Xhorn7/Skripsi-PENGEMBANGAN-ROBOT-AKUATIK-UNTUK-FEEDER-OTOMATIS-DI-TAMBAK/Master Code/Transmitter/README_RASPBERRY.md

# Panduan Menjalankan GUI Feeder di Raspberry Pi

Panel kontrol robot feeder akuatik. Jalankan **satu** berkas `receiverArduino.py`
→ GUI + telemetri + logging langsung aktif.

GUI berjalan **layar penuh mengikuti ukuran layar perangkat**, dirancang untuk
**layar sentuh 7 inci (800 × 480 px)** dengan tata letak bergaya mesin ATM:
tombol besar, tombol STOP yang selalu terlihat, dan papan angka layar penuh
sehingga bisa dioperasikan **tanpa keyboard maupun mouse**.

Layar pembuka hanya menawarkan **dua** pilihan — **MISI** dan **SETTING**.
Tidak ada bilah navigasi: **DASHBOARD terbuka sendiri** begitu misi dikirim.

---

## 1. Kebutuhan

### Perangkat keras
- Raspberry Pi (3/4/5) dengan **Raspberry Pi OS Desktop** (butuh layar/desktop untuk GUI —
  langsung ke monitor HDMI **atau** lewat VNC).
- **Layar sentuh 7 inci** (800 × 480) sebagai tampilan Pengendali Utama.
- Modul **NRF24L01** terhubung ke pin SPI Pi (lihat tabel wiring di bawah).
- Sudut MPU6050 **tidak perlu kabel USB lagi** — robot mengirimkannya sendiri
  lewat telemetri balik NRF.

### Perangkat lunak
- Python 3 (sudah bawaan Raspberry Pi OS).
- Paket sistem: `python3-tk` (untuk GUI), `python3-venv`.
- Paket Python: `customtkinter`, `pyrf24` (lihat `requirements.txt`).

---

## 2. Wiring NRF24L01 → Raspberry Pi

Kode memakai `RF24(24, 0)` → **CE = GPIO24**, **CSN = CE0 (SPI0)**.

| NRF24L01 | Raspberry Pi (BCM) | Pin fisik |
| --- | --- | --- |
| VCC | 3.3V | 1 atau 17 |
| GND | GND | 6, 9, ... |
| CE | GPIO24 | 18 |
| CSN | GPIO8 (CE0) | 24 |
| SCK | GPIO11 (SCLK) | 23 |
| MOSI | GPIO10 (MOSI) | 19 |
| MISO | GPIO9 (MISO) | 21 |

> **PENTING:** VCC NRF **wajib 3.3V** (bukan 5V). Disarankan tambah kapasitor
> 10µF antara VCC–GND modul NRF agar stabil.

---

## 3. Instalasi (sekali saja)

### Cara CEPAT (otomatis) — disarankan

Ekstrak zip ke `~/feeder`, lalu jalankan skrip setup sekali:

```bash
cd ~/feeder
chmod +x setup_pi.sh run.sh
./setup_pi.sh          # aktifkan SPI + apt + venv + pip install
# lalu LOGOUT-LOGIN sekali (agar grup spi/gpio/dialout aktif)
```

Setelah itu langsung ke **bagian 4 (Menjalankan)**.

### Cara MANUAL (kalau ingin bertahap)

Buka Terminal di Raspberry Pi:

```bash
# 3.1 Aktifkan SPI (untuk NRF24)
sudo raspi-config nonint do_spi 0        # 0 = enable
# (atau: sudo raspi-config -> Interface Options -> SPI -> Enable)

# 3.2 Paket sistem
sudo apt update
sudo apt install -y python3-venv python3-tk

# 3.3 Hak akses SPI / GPIO / Serial (lalu logout-login sekali)
sudo usermod -aG spi,gpio,dialout "$USER"

# 3.4 Salin folder ini ke Pi, mis. ke ~/feeder, lalu:
cd ~/feeder

# 3.5 Buat virtualenv (pakai --system-site-packages agar python3-tk terlihat)
python3 -m venv --system-site-packages ~/feeder-venv
source ~/feeder-venv/bin/activate

# 3.6 Install paket Python
pip install -r requirements.txt
```

---

## 4. Menjalankan

```bash
cd ~/feeder
./run.sh                 # buka GUI layar penuh (default)
# atau manual:
source ~/feeder-venv/bin/activate
python3 receiverArduino.py

./run.sh --windowed      # jendela 800x480 (untuk uji/pengembangan)
./run.sh --real          # langsung memakai NRF sungguhan
./run.sh --cli           # mode teks (tanpa GUI)
```

> **Mode awal = SIMULASI.** Aplikasi selalu terbuka dengan **robot virtual**
> supaya aman dipakai berlatih & demo tanpa menyalakan robot. Untuk mengendalikan
> robot sungguhan, sentuh tombol **MODE** di bilah atas (atau pilih **REAL** pada
> **SISTEM → MODE KERJA**, atau jalankan dengan `--real`). Perpindahan mode
> ditolak selagi ada perintah berjalan — tekan **STOP** dulu.

Kalau `run.sh` belum bisa dieksekusi: `chmod +x run.sh` sekali saja.
Saat layar penuh, tombol **Escape** atau **F11** mengembalikan ke mode jendela.

### Navigasi GUI

Alurnya lurus, bukan menu: **BERANDA → MISI → DASHBOARD**. Tombol **‹** di kiri
bilah atas mengembalikan ke beranda; tombol **STOP** merah di kanan aktif dari
halaman mana pun.

1. **BERANDA** — hanya dua tombol besar: **MISI** dan **SETTING**. Selagi ada
   misi berjalan, muncul tombol tambahan **LIHAT DASHBOARD** untuk kembali
   memantau.
2. **MISI** — sentuh kolom **Panjang** / **Lebar** (papan angka terbuka), atur
   lebar lintasan, kecepatan, dan titik awal (bisa juga disentuh langsung di
   peta). Panel kanan menampilkan preview jalur dan **daftar perintah** yang
   akan dikirim. Tekan **KIRIM MISI KE ROBOT** — aplikasi langsung berpindah ke
   DASHBOARD.
3. **DASHBOARD** — layar pemantauan selagi robot bekerja: status (`MENGIRIM
   PERINTAH → ROBOT BERGERAK → SELESAI` mengikuti sinyal `ON`/`FIN`), perintah
   yang sedang dijalankan, kemajuan antrean & sisa waktu, **koordinat sudut MPU
   (Roll/Pitch/Yaw)** yang dikirim robot, gauge baling-baling, serta tombol
   **HENTIKAN (STOP)** berukuran besar.
4. **SETTING** — tiga sub-halaman yang dipilih lewat pemilih di puncak layar:
   - **SISTEM** — saklar NRF / Heartbeat / Motor, pemilih **MODE KERJA**
     (SIMULASI/REAL), indikator monitor, info layar, tombol keluar.
   - **MANUAL** — kirim perintah sendiri: **MAJU dalam METER (0,1–50 m)**,
     **PUTAR KIRI (CCW, 1–180°)**, **PUTAR KANAN (CW, 1–180°)**. Pakai tombol
     −/+ atau **ISI ANGKA** (papan angka menerima pecahan, mis. `2.5`), lalu
     **KIRIM** — layar juga berpindah ke DASHBOARD. Jarak meter otomatis
     dipecah menjadi beberapa paket `FW` 10–200 cm sesuai protokol; jumlah
     paketnya diperlihatkan di bawah angka.
   - **LOG** — catatan realtime seluruh siklus protokol, saklar **Auto-simpan
     TXT** dan **Log MPU** (keduanya **sudah menyala sejak aplikasi dibuka**),
     serta **Export CSV / TXT** untuk simpan sekali jalan.

> **Sudut MPU tidak punya pengaturan port** — datanya ikut telemetri NRF dan
> mengalir sendiri di latar belakang selama heartbeat hidup.

### Berkas log & pembersihan otomatis

Sejak aplikasi dibuka, setiap kejadian (termasuk sudut MPU, satu baris per
detik) ditulis ke `logs/log_feeder_<tanggal>_<jam>.txt` **begitu terjadi**, jadi
catatan uji lapangan tetap utuh walau aplikasi ditutup paksa atau Pi kehilangan
daya. Berkas dalam folder itu yang **lebih tua dari 3 hari dihapus otomatis**
saat aplikasi dibuka dan tiap 6 jam sesudahnya, supaya kartu SD Raspberry Pi
tidak penuh. Berkas yang sedang ditulis tidak pernah ikut terhapus.

---

## 5. Masalah Umum

| Gejala | Penyebab / Solusi |
| --- | --- |
| GUI tak muncul, error `no display` | Jalankan dari sesi Desktop/VNC, bukan SSH polos. Untuk SSH pakai `export DISPLAY=:0` atau aktifkan VNC. |
| Ingin memakai NRF nyata | Mode awal memang SIMULASI. Sentuh tombol **MODE** di bilah atas, atau jalankan `./run.sh --real`. |
| Tombol MODE menolak pindah ke REAL | pyrf24 gagal / SPI belum aktif / wiring salah — pesannya muncul di dialog & log. Cek `ls /dev/spidev*` harus ada. |
| ROBOT = TERPUTUS terus | Robot belum menyala/listening, channel/address beda, atau NRF kurang daya (kapasitor 3.3V). |
| MPU kosong / "menunggu telemetri robot" | Robot belum mengirim telemetri. Pastikan **Heartbeat PING** menyala (SETTING > SISTEM), robot hidup, dan firmware mengirim `R=..;P=..;Y=..`. |
| Angka MPU **merah** + "MPU TIDAK TERBACA" | Robot melapor `S=0`: bus I2C-nya diam. Cek di sisi robot — SDA=GPIO21, SCL=GPIO22, VCC=3.3V, GND tersambung, AD0→GND, kabel I2C jangan panjang & jauhkan dari kabel daya ESC. |
| MPU diam di `Roll=-90.0 Pitch=90.0 Yaw=-0.0` | **Sama dengan di atas** — angka itu sidik jari I2C yang tidak menjawab (`atan2(-6.1e-5, 0) = -90°` PAS), bukan sudut sungguhan. Bukan masalah kalibrasi. |
| Yaw merayap pelan (mis. +0,1°/detik) padahal robot **diam** | Sensor terbaca, tapi **offset gyro belum dihitung** (`calcGyroOffsets` tak pernah jalan → offset = 0). Firmware sekarang menyusulkannya otomatis saat menganggur; Serial akan mencetak `Kalibrasi gyro selesai`. Pastikan robot benar-benar diam & datar saat itu. |
| Perlu tahu penyebab pasti MPU bermasalah | Flash sketch diagnosa: `pio run -e mpudiag -t upload && pio device monitor`. Ia memindai seluruh bus I2C, membaca `WHO_AM_I` & bit SLEEP, mendump 14 byte register mentah, lalu mencetak **vonis** beserta langkah pemeriksaannya. |
| Log lama hilang sendiri | Memang disengaja: berkas > 3 hari dibuang otomatis. Salin dulu lewat **Export CSV/TXT** bila ingin disimpan lama. |
| Auto-simpan berhenti sendiri | Berkas gagal ditulis (kartu SD penuh / read-only). Sebabnya tampil di samping saklar; perbaiki lalu nyalakan lagi. |
| `ModuleNotFoundError: customtkinter` | venv belum diaktifkan / `pip install -r requirements.txt` belum jalan. |

---

## 6. (Opsional) Auto-start saat boot

Buat file `~/.config/autostart/feeder.desktop`:

```ini
[Desktop Entry]
Type=Application
Name=Feeder GUI
Exec=/home/pi/feeder/run.sh
```

Ganti `/home/pi/feeder/` sesuai lokasi foldermu.

---

## 7. Isi Paket

| Berkas | Fungsi |
| --- | --- |
| `receiverArduino.py` | **Entry point** — jalankan ini |
| `feeder_gui.py` | Antarmuka GUI (CustomTkinter) |
| `feeder_core.py` | Backend: perintah FW/CW/CCW/STOP, radio (REAL/SIMULASI), runner, logger + auto-simpan, MPUMonitor |
| `requirements.txt` | Daftar dependensi Python |
| `setup_pi.sh` | Skrip instalasi otomatis (jalankan sekali) |
| `run.sh` | Launcher (aktifkan venv + jalankan) |
| `Dokumentasi_GUI_Feeder_SDLC.pdf` | Dokumentasi lengkap (metode SDLC) |
| `logs/` | Berkas auto-simpan TXT (dibuat otomatis; isi > 3 hari dihapus sendiri) |
