Xhorn7/Skripsi-PENGEMBANGAN-ROBOT-AKUATIK-UNTUK-FEEDER-OTOMATIS-DI-TAMBAK/Master Code/Robot/New/Finalnew/Pin Details.txt

NRF24:
| NRF24 | ESP32  |
| ----- | --- |
| CE | GPIO4 |
| CSN | GPIO5 |
| MOSI  | GPIO23 |
| MISO  | GPIO19 |
| SCK | GPIO18 |
| VCC | 3.3V |
| GND | GND |

MPU6050:
| MPU6050 | ESP32  |
| --- | --- |
| SDA | GPIO21 |
| SCL | GPIO22 |
| VCC | 3.3V |
| GND | GND |

ESC (motor):
| ESC | ESP32 |
| --- | --- |
| Signal Left  | GPIO25 |
| Signal Right | GPIO26 |
| GND ESC | GND ESP32 |
