Xhorn7/Skripsi-PENGEMBANGAN-ROBOT-AKUATIK-UNTUK-FEEDER-OTOMATIS-DI-TAMBAK/Flowchart Images/02-2-flowchart-pengendali-utama-transmitter.png

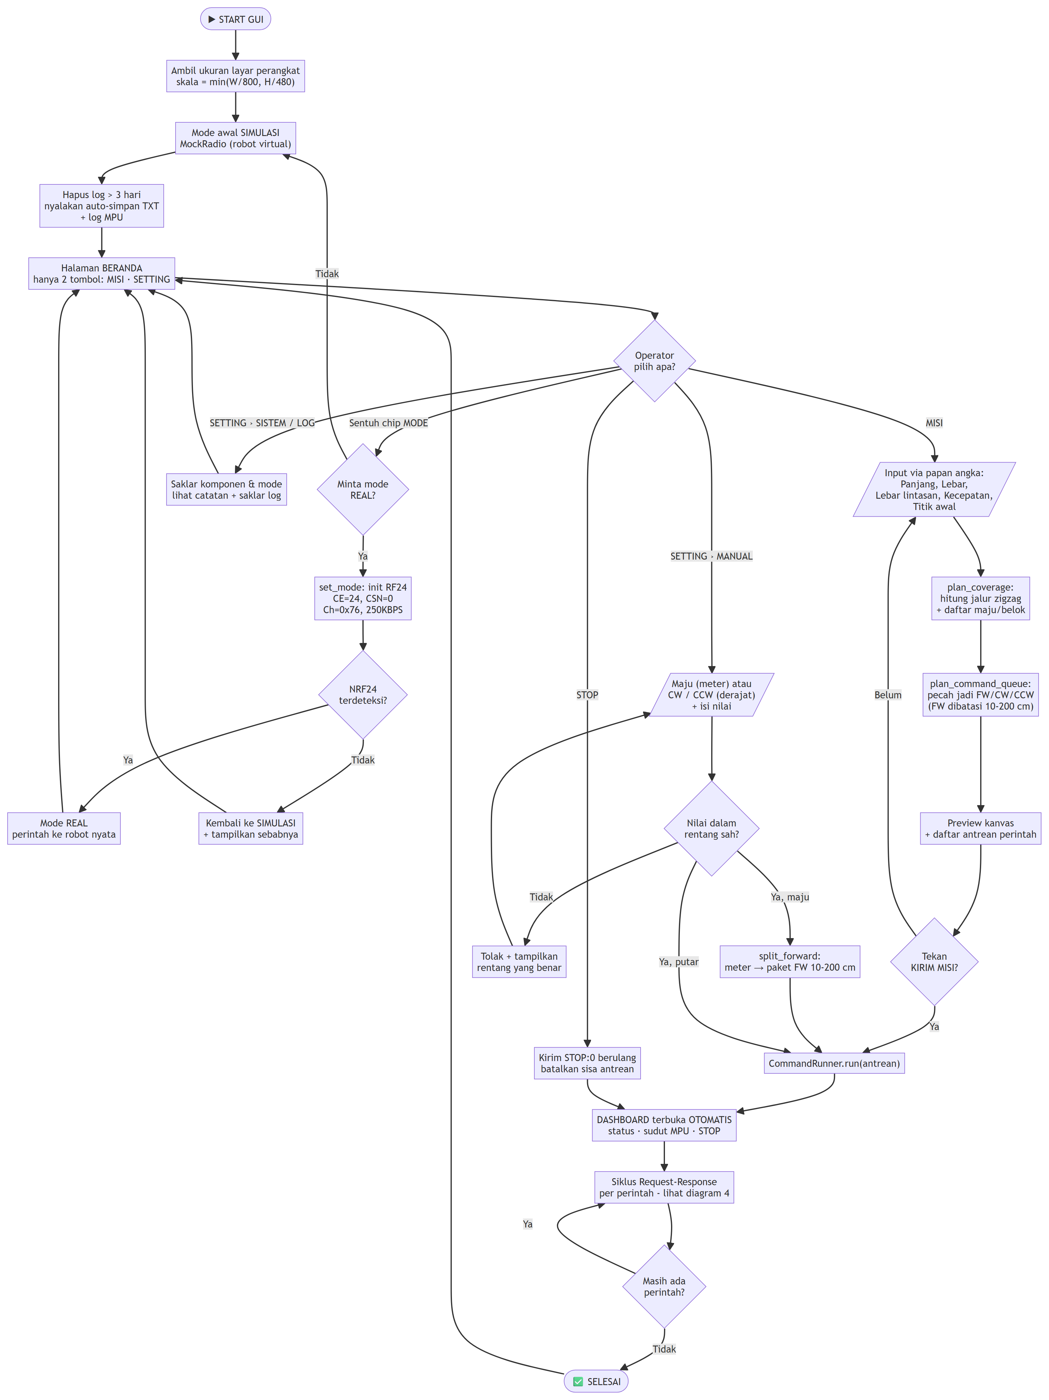
Flowchart Images/02-2-flowchart-pengendali-utama-transmitter.png
