Xhorn7/Skripsi-PENGEMBANGAN-ROBOT-AKUATIK-UNTUK-FEEDER-OTOMATIS-DI-TAMBAK/Flowchart Images/03-3-flowchart-body-robot-receiver.png

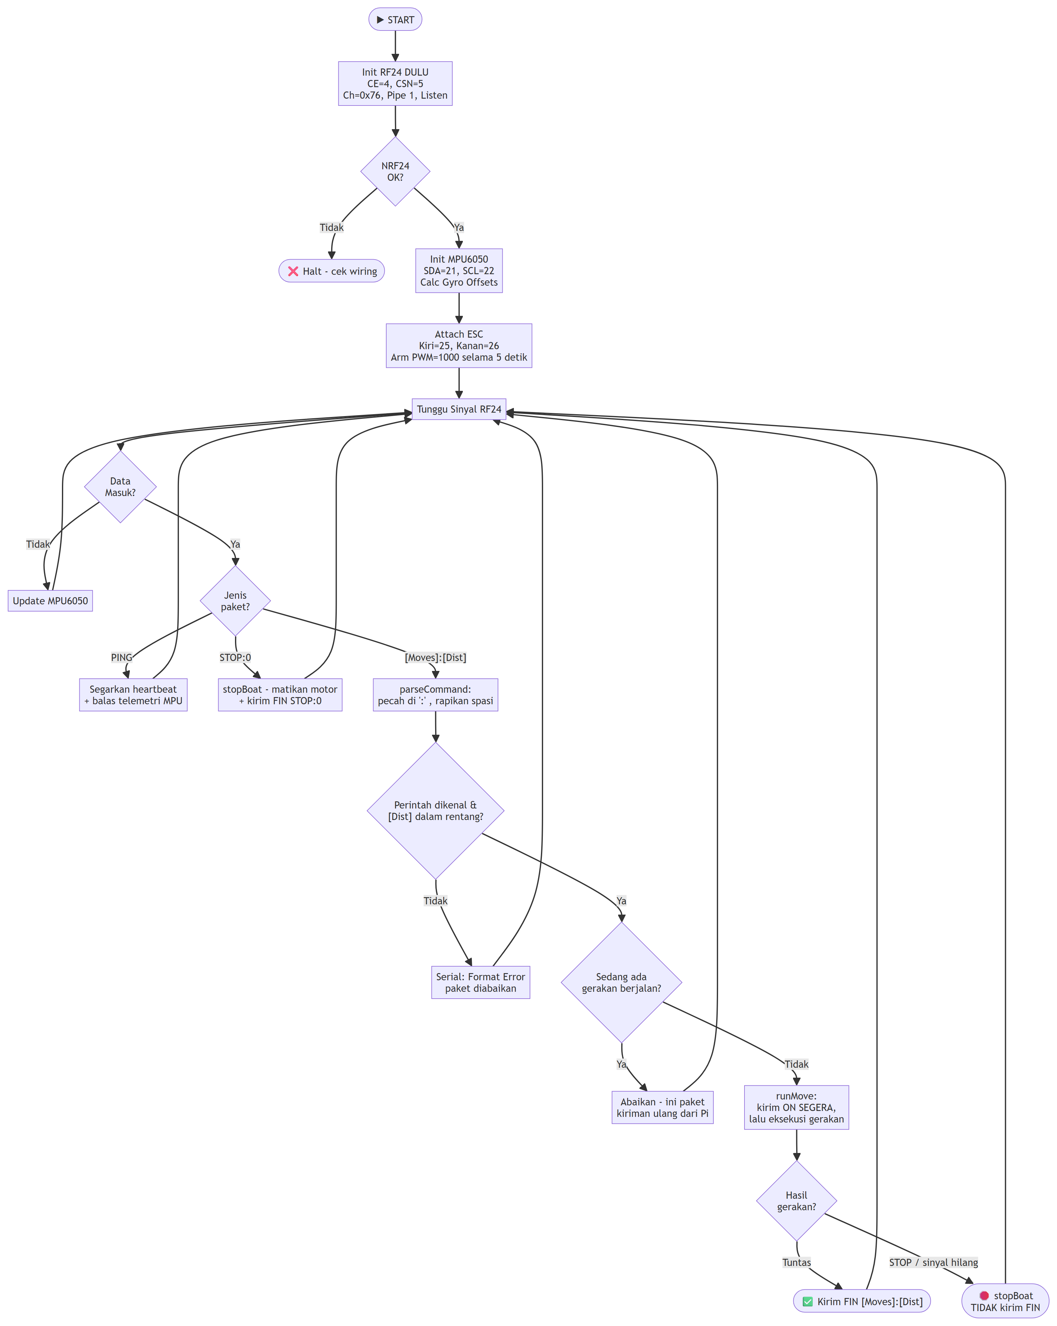
Flowchart Images/03-3-flowchart-body-robot-receiver.png
