Xhorn7/Skripsi-PENGEMBANGAN-ROBOT-AKUATIK-UNTUK-FEEDER-OTOMATIS-DI-TAMBAK/Flowchart Images/04-4-siklus-request-response-satu-perintah.png

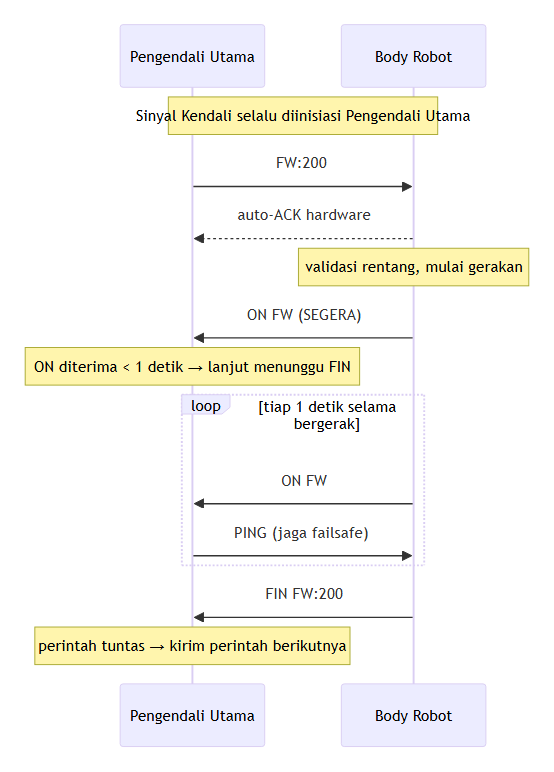
Flowchart Images/04-4-siklus-request-response-satu-perintah.png
