Xhorn7/Skripsi-PENGEMBANGAN-ROBOT-AKUATIK-UNTUK-FEEDER-OTOMATIS-DI-TAMBAK/Flowchart Images/05-4-siklus-request-response-satu-perintah-2.png

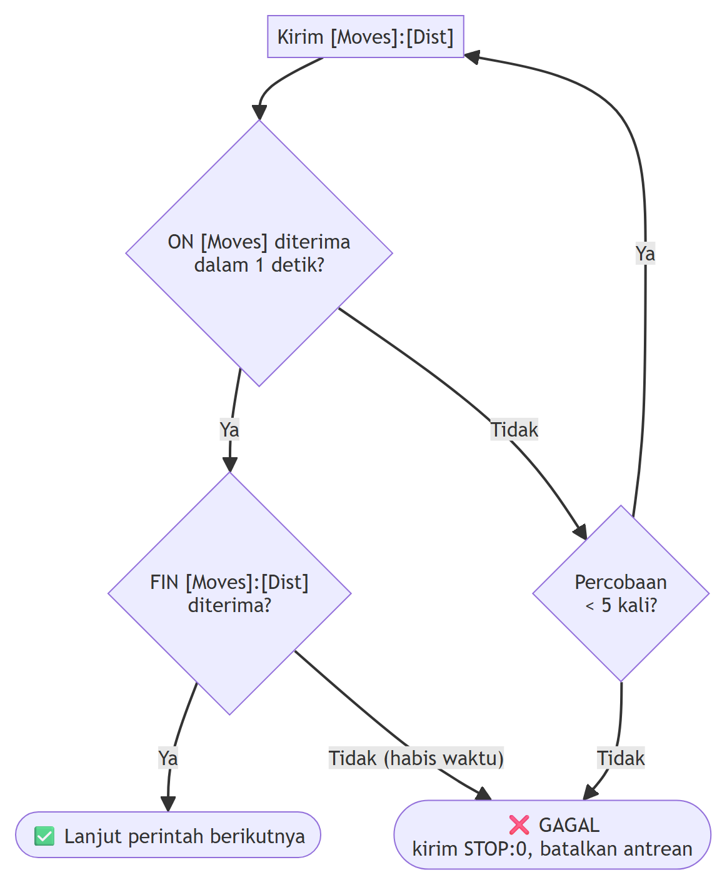
Flowchart Images/05-4-siklus-request-response-satu-perintah-2.png
