Xhorn7/Skripsi-PENGEMBANGAN-ROBOT-AKUATIK-UNTUK-FEEDER-OTOMATIS-DI-TAMBAK/Flowchart Images/06-5-perintah-fw-heading-hold-proporsional-executeforward.png

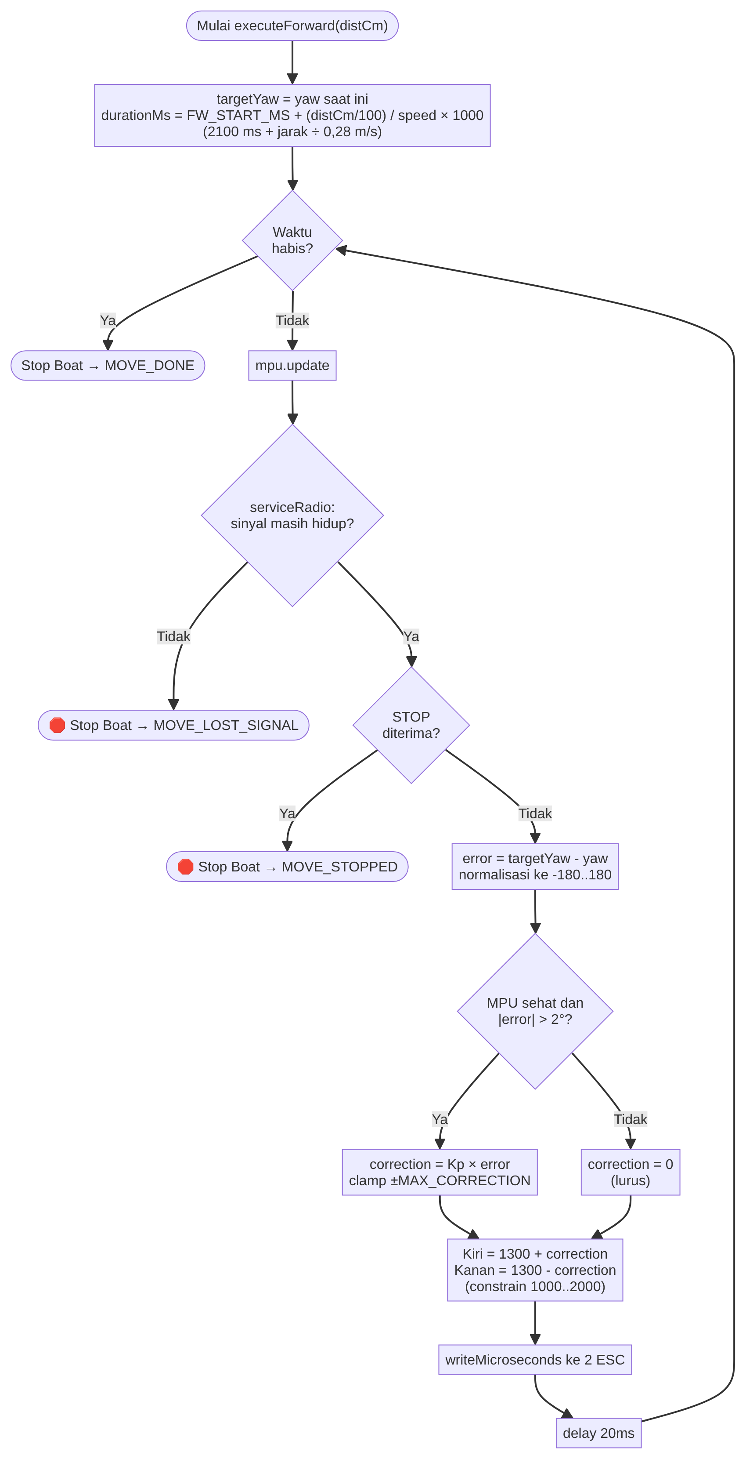
Flowchart Images/06-5-perintah-fw-heading-hold-proporsional-executeforward.png
