Xhorn7/Skripsi-PENGEMBANGAN-ROBOT-AKUATIK-UNTUK-FEEDER-OTOMATIS-DI-TAMBAK/Flowchart Images/07-6-perintah-cw-ccw-putaran-closed-loop-yaw-executeturn.png

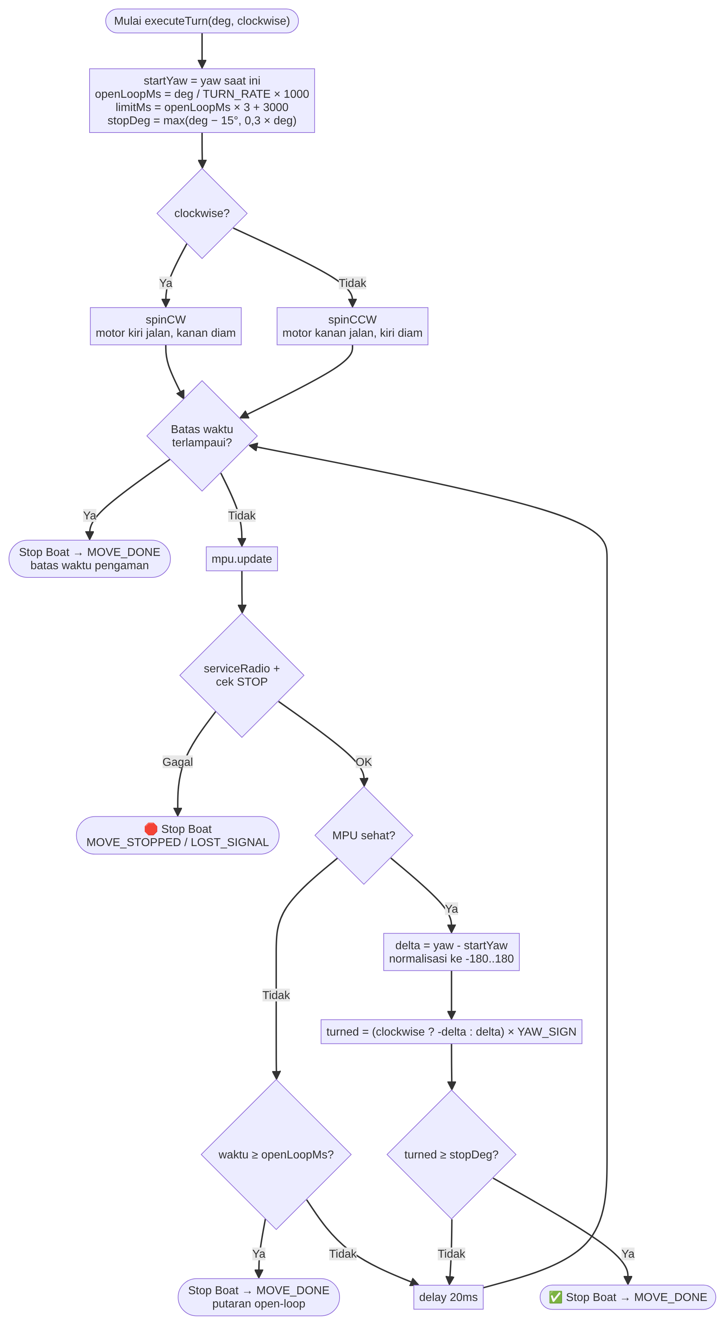
Flowchart Images/07-6-perintah-cw-ccw-putaran-closed-loop-yaw-executeturn.png
