Xhorn7/Skripsi-PENGEMBANGAN-ROBOT-AKUATIK-UNTUK-FEEDER-OTOMATIS-DI-TAMBAK/Flowchart Images/08-7-perencanaan-jalur-antrean-perintah.png

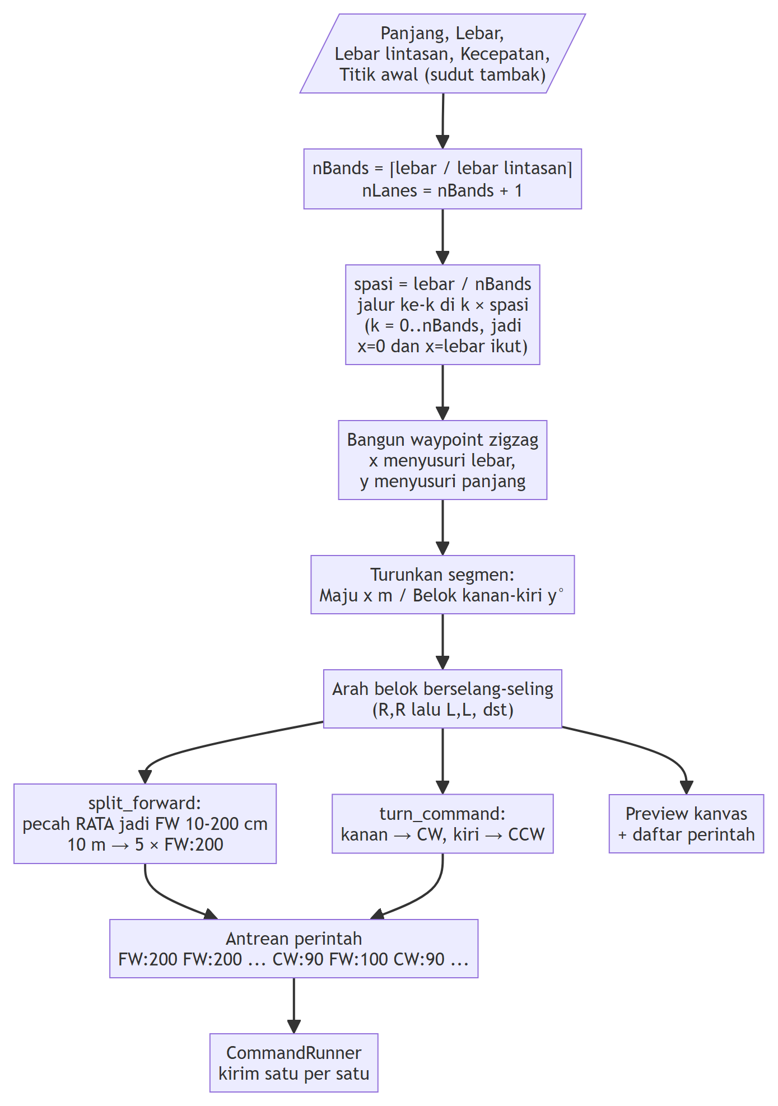
Flowchart Images/08-7-perencanaan-jalur-antrean-perintah.png
