Xhorn7/Skripsi-PENGEMBANGAN-ROBOT-AKUATIK-UNTUK-FEEDER-OTOMATIS-DI-TAMBAK/Flowchart Images/09-8-sinyal-balik-telemetri-half-duplex-gantian.png

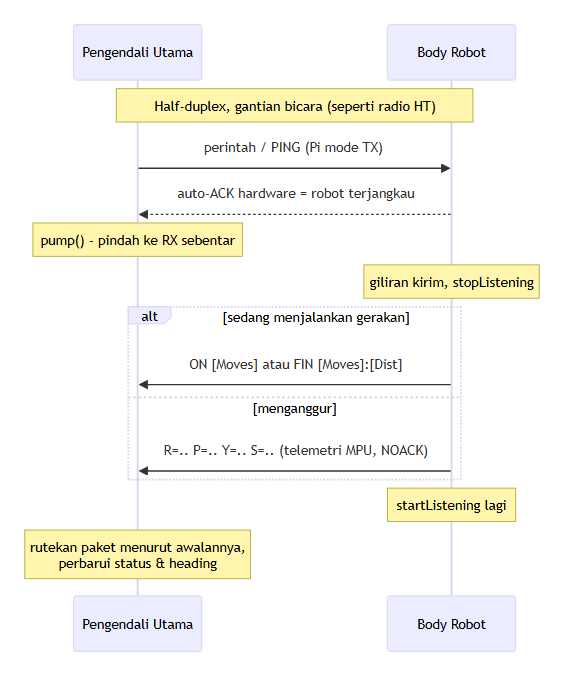
Flowchart Images/09-8-sinyal-balik-telemetri-half-duplex-gantian.png
