Xhorn7/Skripsi-PENGEMBANGAN-ROBOT-AKUATIK-UNTUK-FEEDER-OTOMATIS-DI-TAMBAK/Master Code/Transmitter/gui_beranda.png

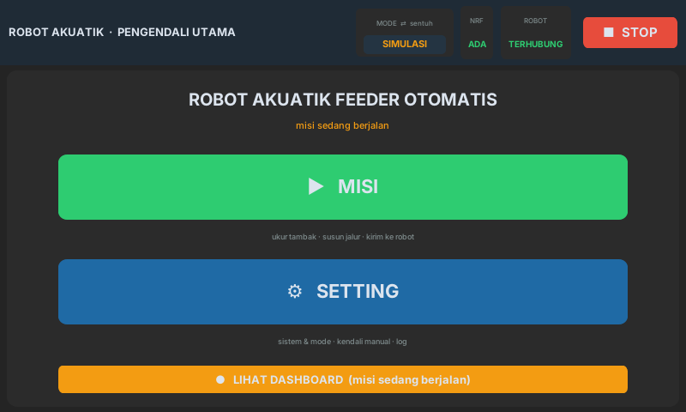
Master Code/Transmitter/gui_beranda.png
