Xhorn7/Skripsi-PENGEMBANGAN-ROBOT-AKUATIK-UNTUK-FEEDER-OTOMATIS-DI-TAMBAK/Pengujian/foto_c1/C1-1_akhir.webp

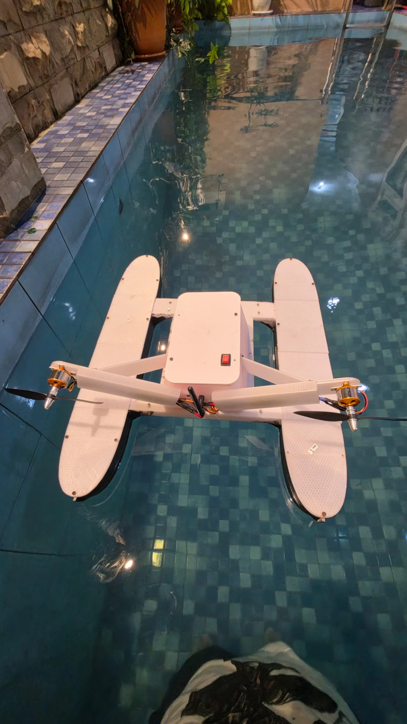
Pengujian/foto_c1/C1-1_akhir.webp
