Xhorn7/Skripsi-PENGEMBANGAN-ROBOT-AKUATIK-UNTUK-FEEDER-OTOMATIS-DI-TAMBAK/Pengujian/foto_c1/C1-2_akhir_C1-3_awal.webp

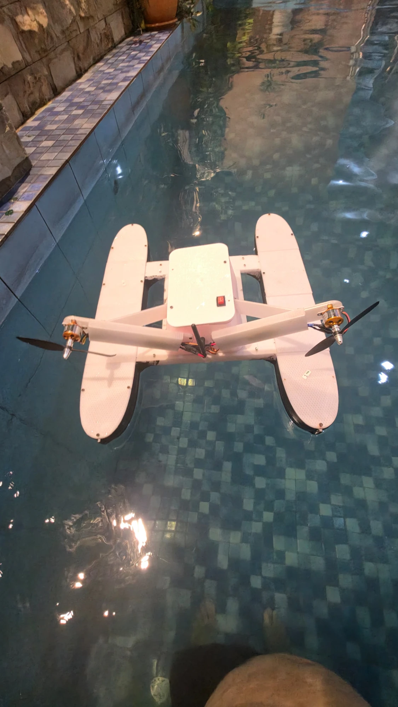
Pengujian/foto_c1/C1-2_akhir_C1-3_awal.webp
