Xhorn7/Skripsi-PENGEMBANGAN-ROBOT-AKUATIK-UNTUK-FEEDER-OTOMATIS-DI-TAMBAK/Pengujian/gambar/fig_c1_rute_aktual.png

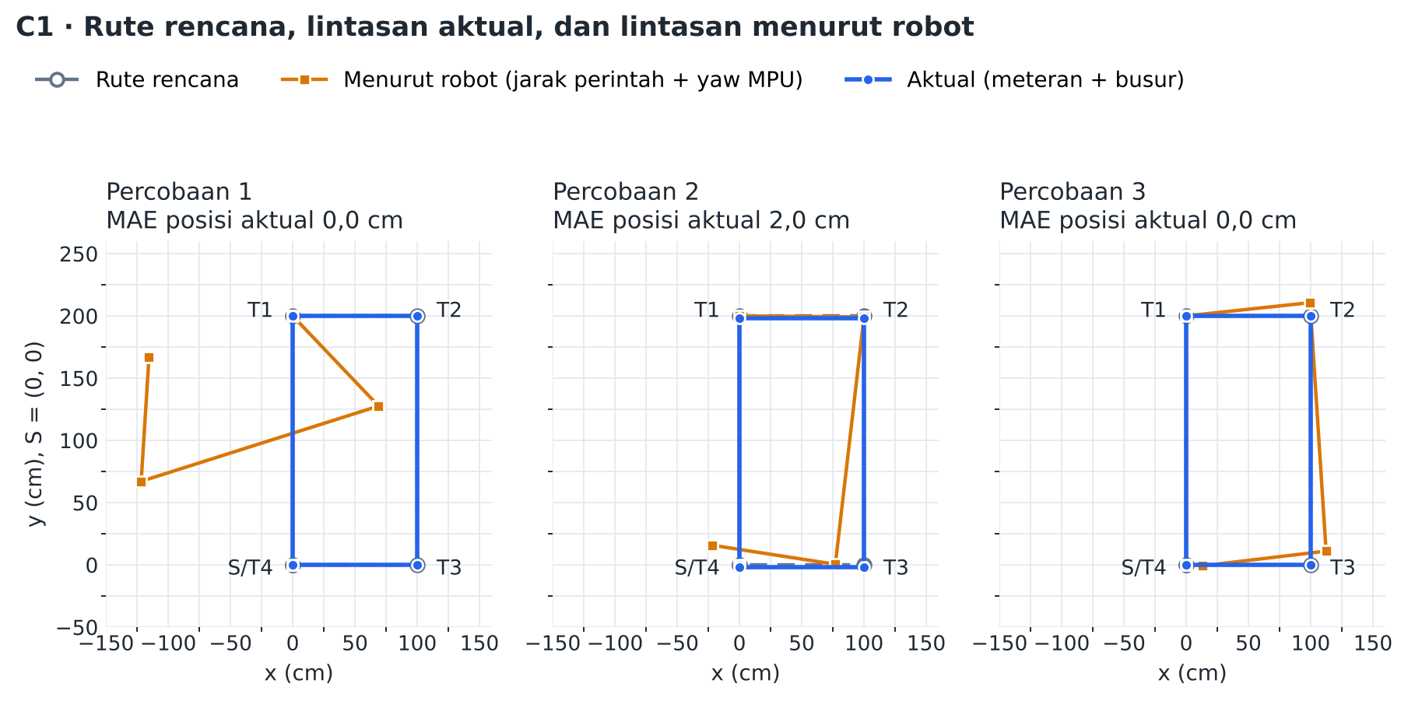
Pengujian/gambar/fig_c1_rute_aktual.png
