Xhorn7/Skripsi-PENGEMBANGAN-ROBOT-AKUATIK-UNTUK-FEEDER-OTOMATIS-DI-TAMBAK/Pengujian/gambar/fig_kolam_skenario.png

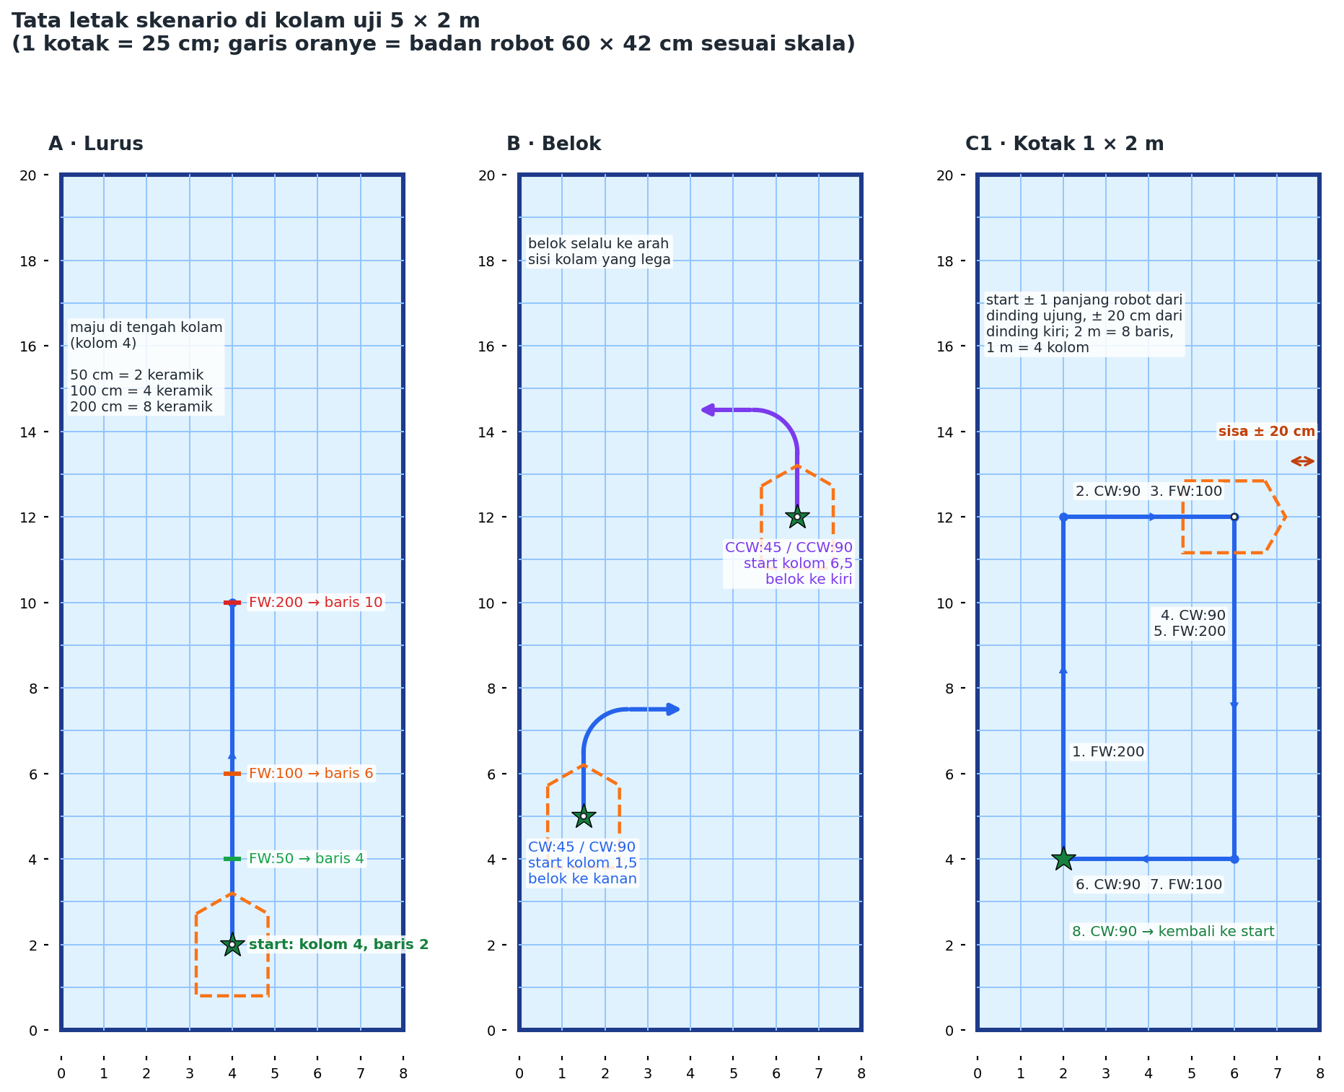
Pengujian/gambar/fig_kolam_skenario.png
