Xhorn7/Skripsi-PENGEMBANGAN-ROBOT-AKUATIK-UNTUK-FEEDER-OTOMATIS-DI-TAMBAK/Pengujian/Lembar_Data_Pengujian_Sebelum Kalibrasi.xlsx

Sheet: Data Sesi
Data Sesi Pengujian
Tanggal / jam mulai | 29 September 2026 12:00 WIB
Ukuran 1 keramik (cm) | 25 cm
Ukuran 1 mozaik (cm) | 4.1 cm
Pojok acuan (0 ; 0) | 1:4
Baterai penuh saat mulai (Y/T) | Y
Status MPU (S)
ROBOT_SPEED_MPS
KP_HEADING
Ukuran melintang C1/C2 (hasil uji coba ruang)
Cuaca / angin / riak air | Hujan
Pencatat
Cara pakai
1. Tiap skenario punya satu sheet. Isi hanya sel kuning.
2. Skenario A: isi baris saat FIN (kalau sempat), lalu kolom & baris posisi akhir.
3. Skenario B & C: isi posisi haluan dan buritan setelah robot diam.
4. Jarak, galat, sudut, rata-rata, MAE, MAPE, dan simpangan baku terhitung sendiri.

Sheet: A1
A1 — FW:50 (target 50 cm, start kolom 4 ; baris 2)
Perc. | Baris saat FIN (opsional) | Kolom akhir | Baris akhir | Jarak aktual (cm) | Galat (cm) | Galat (%) | Lateral (cm) | Jarak luncur (cm) | Kirim ulang? (Y/T) | Keterangan
1 |  | 4 | 2 | 0 | -50 | -100 | 0 |  | T
2 |  | 4 | 2 | 0 | -50 | -100 | 0 |  | T
3 |  | 4 | 2 | 0 | -50 | -100 | 0 |  | T
Rata-rata |  | 4 | 2 | 0 | -50 | -100 | 0 |  | T
Simpangan baku |  | 0 | 0 | 0 | 0 | 0 | 0 |  | T
MAE (cm) | 50
MAPE (%) | 100
Kuning = diisi manual (hasil baca grid keramik). Abu-abu = otomatis, jangan diketik.

Sheet: A2
A2 — FW:100 (target 100 cm, start kolom 4 ; baris 2)
Perc. | Baris saat FIN (opsional) | Kolom akhir | Baris akhir | Jarak aktual (cm) | Galat (cm) | Galat (%) | Lateral (cm) | Jarak luncur (cm) | Kirim ulang? (Y/T) | Keterangan
1 |  | 4.5 | 2 | 0 | -100 | -100 | 12.5
2 |  | 4.5 | 2 | 0 | -100 | -100 | 12.5
3 |  | 4.5 | 2 | 0 | -100 | -100 | 12.5
Rata-rata |  | 4.5 | 2 | 0 | -100 | -100 | 12.5
Simpangan baku |  | 0 | 0 | 0 | 0 | 0 | 0
MAE (cm) | 100
MAPE (%) | 100
Kuning = diisi manual (hasil baca grid keramik). Abu-abu = otomatis, jangan diketik.

Sheet: A3
A3 — FW:200 (target 200 cm, start kolom 4 ; baris 2)
Perc. | Baris saat FIN (opsional) | Kolom akhir | Baris akhir | Jarak aktual (cm) | Galat (cm) | Galat (%) | Lateral (cm) | Jarak luncur (cm) | Kirim ulang? (Y/T) | Keterangan
1 |  | 4 | 5 | 75 | -125 | -62.5 | 0
2 |  | 4 | 5 | 75 | -125 | -62.5 | 0
3 |  | 4 | 5 | 75 | -125 | -62.5 | 0
Rata-rata |  | 4 | 5 | 75 | -125 | -62.5 | 0
Simpangan baku |  | 0 | 0 | 0 | 0 | 0 | 0
MAE (cm) | 125
MAPE (%) | 62.5
Kuning = diisi manual (hasil baca grid keramik). Abu-abu = otomatis, jangan diketik.

Sheet: B1
B1 — CW:45 (target 45°, arah awal 0° sejajar garis baris)
Perc. | Yaw MPU awal (°) | Yaw MPU akhir (°) | Haluan kolom | Haluan baris | Buritan kolom | Buritan baris | Sudut MPU (°) | Sudut aktual (°) | Galat aktual (°) | Galat MPU vs aktual (°) | Keterangan
1
2
3
Rata-rata
Simpangan baku
MAE sudut (°)
MAE MPU (°)
Kuning = diisi manual (hasil baca grid keramik). Abu-abu = otomatis, jangan diketik.

Sheet: B2
B2 — CW:90 (target 90°, arah awal 0° sejajar garis baris)
Perc. | Yaw MPU awal (°) | Yaw MPU akhir (°) | Haluan kolom | Haluan baris | Buritan kolom | Buritan baris | Sudut MPU (°) | Sudut aktual (°) | Galat aktual (°) | Galat MPU vs aktual (°) | Keterangan
1
2
3
Rata-rata
Simpangan baku
MAE sudut (°)
MAE MPU (°)
Kuning = diisi manual (hasil baca grid keramik). Abu-abu = otomatis, jangan diketik.

Sheet: B3
B3 — CCW:45 (target 45°, arah awal 0° sejajar garis baris)
Perc. | Yaw MPU awal (°) | Yaw MPU akhir (°) | Haluan kolom | Haluan baris | Buritan kolom | Buritan baris | Sudut MPU (°) | Sudut aktual (°) | Galat aktual (°) | Galat MPU vs aktual (°) | Keterangan
1
2
3
Rata-rata
Simpangan baku
MAE sudut (°)
MAE MPU (°)
Kuning = diisi manual (hasil baca grid keramik). Abu-abu = otomatis, jangan diketik.

Sheet: B4
B4 — CCW:90 (target 90°, arah awal 0° sejajar garis baris)
Perc. | Yaw MPU awal (°) | Yaw MPU akhir (°) | Haluan kolom | Haluan baris | Buritan kolom | Buritan baris | Sudut MPU (°) | Sudut aktual (°) | Galat aktual (°) | Galat MPU vs aktual (°) | Keterangan
1
2
3
Rata-rata
Simpangan baku
MAE sudut (°)
MAE MPU (°)
Kuning = diisi manual (hasil baca grid keramik). Abu-abu = otomatis, jangan diketik.

Sheet: C1
C1 — Kotak 1 x 2 m (target kolom 2 ; baris 4)
Perc. | Kolom akhir | Baris akhir | Haluan kolom | Haluan baris | Buritan kolom | Buritan baris | Δ kolom | Δ baris | Galat posisi (cm) | Arah akhir (°) | FIN (…/8) | Waktu total (s) | Keterangan
1
2
3
Rata-rata
Simpangan baku
MAE posisi (cm)
Kuning = diisi manual (hasil baca grid keramik). Abu-abu = otomatis, jangan diketik.

Sheet: C2
C2 — Zigzag mini (target kolom 2 ; baris 4)
Perc. | Kolom akhir | Baris akhir | Haluan kolom | Haluan baris | Buritan kolom | Buritan baris | Δ kolom | Δ baris | Galat posisi (cm) | Arah akhir (°) | FIN (…/13) | Waktu total (s) | Keterangan
1
2
3
Rata-rata
Simpangan baku
MAE posisi (cm)
Kuning = diisi manual (hasil baca grid keramik). Abu-abu = otomatis, jangan diketik.
