Xhorn7/Skripsi-PENGEMBANGAN-ROBOT-AKUATIK-UNTUK-FEEDER-OTOMATIS-DI-TAMBAK/Schematic/Schematic New.pdf

### ESP32-WROOM-32

### NRF24L01+

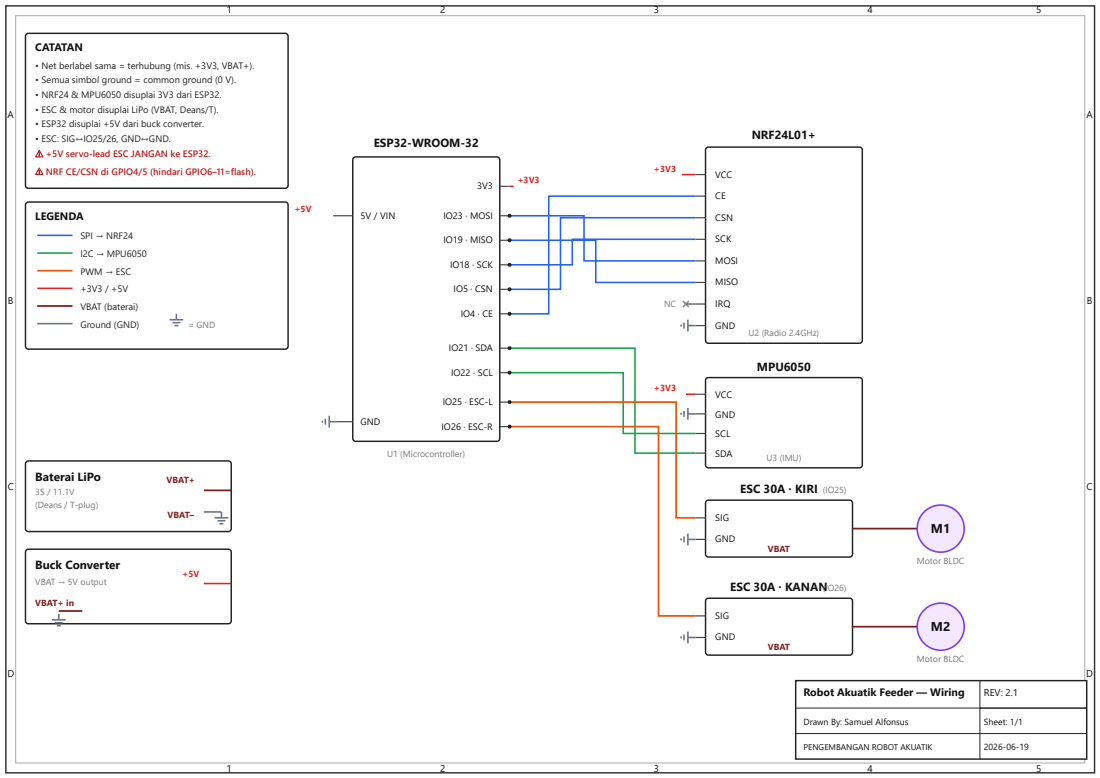
[picture p44: page 1]
LEGENDA; SPI → NRF24 I2C → MPU6050 PWM → ESC +3V3 / +5V VBAT (baterai); Ground (GND); = GND; Baterai LiPo; 3S / 11.1V (Deans / T-plug); VBAT+; VBAT–; Buck Converter; VBAT → 5V output; VBAT+ in; U1 (Microcontroller); 5V / VIN; GND; IO23 · MOSI; IO19 · MISO; IO18 · SCK; IO5 · CSN; IO21 · SDA; IO22 · SCL; IO25 · ESC-L; IO26 · ESC-R; U2 (Radio 2.4GHz); VCC; CSN; SCK; MOSI; MISO; IRQ; MPU6050; U3 (IMU); SCL; SDA; ESC 30A · KIRI (IO25); SIG; VBAT; Motor BLDC; ESC 30A · KANAN(IO26)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

CATATAN
• Net berlabel sama = terhubung (mis. +3V3, VBAT+).
• Semua simbol ground = common ground (0 V).
• NRF24 & MPU6050 disuplai 3V3 dari ESP32.
• ESC & motor disuplai LiPo (VBAT, Deans/T).
• ESP32 disuplai +5V dari buck converter.
• ESC: SIG↔IO25/26, GND↔GND.
⚠ +5V servo-lead ESC JANGAN ke ESP32.
⚠ NRF CE/CSN di GPIO4/5 (hindari GPIO6–11=flash).
