Xhorn7/Skripsi-PENGEMBANGAN-ROBOT-AKUATIK-UNTUK-FEEDER-OTOMATIS-DI-TAMBAK/Schematic/Fritzing/Schematic.pdf

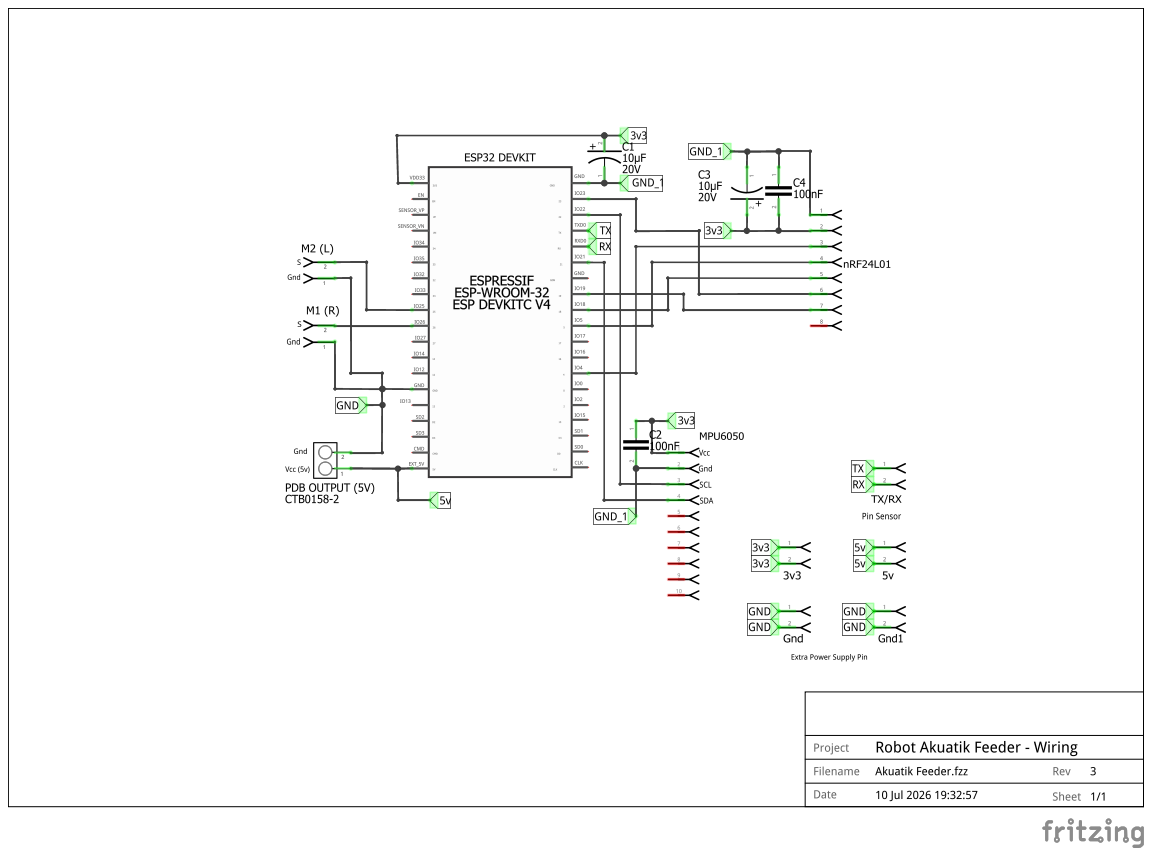
[picture p45: page 1]
