Xhorn7/Skripsi-PENGEMBANGAN-ROBOT-AKUATIK-UNTUK-FEEDER-OTOMATIS-DI-TAMBAK/(commit log)

2026-05-18 adding improvement for transmitter and receiver arduino script
2026-05-27 add all fixing with transmitter from rasperry pi4 and receiver modified
    [Receiverfiks.ino, Transmitterfiks.ino, receiver-fiksss.ino, receivernew.ino]
2026-06-09 adding pin details
2026-06-14 adding flowchart and update schematic using new configuration
2026-06-17 adding platform io for running arduino in vscode
2026-06-19 edit pin nrf and update schematic
2026-06-20 adding file organizer, add motor test code, and edit some env like gitignore
2026-07-11 adding custom pcb and schematic using fritzing
2026-07-25 adding many improvement and custom PCB file
2026-07-25 Update readme, flowchart documentation
2026-08-17 fixing MPU and display route in GUI
    [Finalnew.ino, MoveTest.ino, MpuDiag.ino, build_docs_pdf.py, build_raspberry_zip.py, feeder_core.py, feeder_gui.py, mpu.ino]
2026-09-07 adapt MPU code to MPU-9250/6500, add I2C bus recovery + NRF diagnostic
    Sensor modul diganti ke papan "MPU-9250/6500". WHO_AM_I terbaca 0x70 = chip
    MPU-6500, jadi TANPA magnetometer; kode AK8963 tetap disertakan dan menyala
    sendiri bila suatu saat dipasang 9250 asli (0x71).
    MPU (mpu.ino + Finalnew.ino):
    - calcGyroOffsetsSafe() menggantikan mpu.calcGyroOffsets() bawaan pustaka.
    Pustaka tockn menembak 3000 transaksi I2C tanpa memeriksa kegagalan dan
    menggantung selamanya bila bus tersendat — di Finalnew itu berarti loop()
    tidak pernah tercapai dan radio ikut mati. Versi baru memeriksa tiap
    pembacaan, memulihkan bus, lalu melapor bila gagal.
    - Pengukur simpangan saat kalibrasi: offset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
2026-09-07 docs: sesuaikan panduan Raspberry dengan susunan Pi yang dipakai
    Panduan sebelumnya ditulis mengikuti README_RASPBERRY.md (instalasi dari
    raspberry_feeder.zip ke ~/feeder, dijalankan dengan ./run.sh). Pi yang benar-
    benar dipakai susunannya berbeda: program ada di ~/Desktop/Skripsi_Tambak dan
    dijalankan dengan "sudo bash setup.sh" lalu "sudo bash run.sh".
    - Perintah & path disesuaikan dengan Pi yang dipakai
    - Bagian instalasi dari zip dihapus — Pi sudah ter-setup
    - Ditambah langkah cek WiFi SmartRoomPrototype
    - Ditambah peringatan huruf besar-kecil pada nama folder + saran memakai Tab,
    karena "cd desktop" akan gagal sementara "cd Desktop" berhasil
    - Ditambah catatan kata sandi sudo tida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
2026-09-07 docs: tambah PDF panduan operasional + generatornya
    Panduan operator dipegang di lapangan dan sering dicetak, jadi bentuk PDF-nya
    ikut dipelihara — bukan hanya berkas Markdown-nya.
    - build_panduan_pdf.py: mengubah PANDUAN_OPERASIONAL_RASPBERRY.md jadi PDF.
    Palet warna & tata letak disamakan dengan build_docs_pdf.py supaya seluruh
    dokumen proyek terlihat satu kesatuan.
    - Karakter di luar WinAnsi (panah, simbol petir, garis kotak) diganti padanan
    ASCII lebih dulu; font bawaan reportlab mencetaknya sebagai kotak kosong.
    - Blok kutipan Markdown dirender sebagai kotak peringatan berlatar kuning —
    di panduan ini isinya memang peringatan yang tidak boleh terlewat (urutan
    colok HDMI,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
    [build_panduan_pdf.py]
2026-09-11 docs: skenario uji cukup HP + meteran, generator bisa di PC/laptop
    - Metode ukur disederhanakan: tepi kolam jadi garis acuan, jarak diukur
    meteran di sepanjang tepi, sudut dari foto HP tampak atas. Tali
    bertanda, tripod, stiker, pelampung, multimeter, dan Tracker/Kinovea
    tidak lagi diperlukan.
    - ukur_foto.py: klik tepi kolam + buritan/haluan robot pada foto
    sebelum & sesudah, keluar sudut belok aktual dan foto beranotasi.
    - build_skenario.py: generator DOCX/PDF + gambar dipindah ke repo
    (sebelumnya hanya ada di laptop), path relatif, PDF lewat Word atau
    LibreOffice bila ada.
    - Zigzag C2 diganti tambak 2x3 m (4 lintasan) agar robot berakhir di
    sisi tepi yang sama dengan start da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
2026-09-22 docs: ukur sudut belok pakai kompas, bukan hitungan dari foto
    Masukan dospem: perhitungan dari HP perlu dicek kebenarannya, lebih
    baik pakai alat ukur beneran. Sesuai dua paper referensinya, ground
    truth diambil dari alat ukur fisik.
    - Sudut belok (B1-B4) dan galat arah akhir (C1) kini dibaca langsung
    dari kompas: azimuth sebelum dan sesudah belok.
    - Tambah langkah uji gangguan magnet motor pada kompas saat kalibrasi.
    - Lembar data B/C1 diganti kolom azimuth kompas awal/akhir.
    - ukur_foto.py tetap ada, tapi hanya untuk dokumentasi/cross-check.
2026-09-22 docs: skenario uji versi kolam 5x2 m, ukur pakai grid keramik
    - Lokasi uji jadi kolam 5 x 2 m; lantai keramik 25 x 25 cm (8 kolom x
    20 baris) dipakai sebagai grid alat ukur posisi, seperti area uji
    bergrid pada paper referensi dospem. Tidak perlu membeli alat.
    - Posisi start/target tiap skenario ditulis dalam koordinat keramik;
    ukuran robot 60 x 42 cm digambar sesuai skala.
    - Sudut dari posisi haluan-buritan di grid, lengkap dengan tabel
    konversi; metrik MAE/MAPE mengikuti referensi.
    - Zigzag mini diperkecil (4 lintasan melintang 1 m, 13 perintah).
    - Tambah uji coba ruang untuk menentukan ukuran melintang C1/C2 dan
    pencatatan jarak luncur akibat inersia.
    - Hapus metode kompas, ukur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
2026-09-29 docs: pengujian jadi 3 pengulangan + lembar data Excel otomatis
    - Tiap skenario diulang 3 kali (27 percobaan), estimasi waktu dan
    lembar data disesuaikan.
    - Tambah buat_lembar_data.py yang menghasilkan
    Lembar_Data_Pengujian.xlsx: sel kuning diisi hasil baca grid
    keramik, jarak/galat/lateral/jarak luncur/sudut/MAE/MAPE/simpangan
    baku terhitung otomatis dan aman untuk baris yang belum diisi.
    [Lembar_Data_Pengujian.xlsx]
2026-09-29 docs: perbarui PDF skenario uji ke versi 3 pengulangan
    Sekalian abaikan file kunci Office (~$*) yang muncul saat dokumen
    sedang dibuka di Word/Excel.
2026-09-29 docs: tambah gambar sistem koordinat kolam dan tetapkan pojok nol
    - Gambar baru di bagian 3: kolom dihitung ke samping (sisi pendek),
    baris dihitung ke depan (sisi panjang), contoh titik (4 ; 2) dan
    (6 ; 12).
    - Pojok (0 ; 0) ditetapkan sebagai pojok kiri di ujung dekat tangga,
    dengan operator berdiri di ujung tersebut menghadap panjang kolam.
    - Nomor gambar disesuaikan (Gambar 1-3).
2026-10-01 kalibrasi ROBOT_SPEED_MPS ke 0.135 m/s dari uji kolam
    FW:200 tiga kali di kolam uji hanya menempuh 50, 62.5, dan 50 cm
    (rata-rata 54 cm), jadi kecepatan nyata = 0.5 x 54 / 200 = 0.135 m/s.
    Dengan 0.5 m/s motor dimatikan terlalu cepat sehingga semua perintah FW
    kurang jauh.
    Nilai diubah bersamaan di firmware dan feeder_core.py: aplikasi memakai
    konstanta yang sama untuk batas tunggu FIN (2 x perkiraan + 6 s). Bila
    hanya firmware yang diubah, FW:200 (sekarang 14,8 s) melewati batas 14 s
    dan antrean dibatalkan. Isian default kecepatan di halaman MISI kini
    mengikuti konstanta, dan paket raspberry_feeder.zip dibuat ulang.
2026-10-01 kalibrasi FW pakai awalan 2,1 s + 0,28 m/s
    Dengan 0.135 m/s (dari satu titik FW:200 = 4 s -> 54 cm), FW:100 yang
    kini menyalakan motor 7,4 s menempuh 150 cm (baris 2 -> 8, tiga kali).
    Dua titik itu menunjukkan robot lambat di awal lalu melaju ~0,28 m/s:
    (150 - 54) cm / (7,4 - 4,0) s = 28 cm/s, dengan awalan sekitar 2,1 s
    sebelum gerak berarti. Model ini juga cocok dengan uji awal FW:50 (1 s)
    dan FW:100 (2 s) yang hampir tidak bergerak.
    Durasi FW kini FW_START_MS + jarak / ROBOT_SPEED_MPS, di firmware dan
    feeder_core.py (batas tunggu FIN ikut menyesuaikan). Paket Pi dibuat ulang.
2026-10-03 perbaiki arah putar CW/CCW karena kabel ESC tersilang
    Uji kolam B1: CW:45 berbelok ke KIRI dan berputar jauh melewati 45°
    (± 90°, sekali 168°). Penyebabnya kabel ESC tersilang: ESC_LEFT_PIN
    (GPIO25) menggerakkan motor kanan secara fisik. spinCW() menyalakan
    motor yang salah sehingga robot berputar berlawanan arah perintah;
    kemajuan yaw yang dihitung executeTurn() menjadi negatif, ambang 42°
    tak pernah tercapai, dan putaran baru berhenti di batas waktu pengaman
    (5,25 s untuk 45°).
    Heading-hold FW sudah benar dengan susunan kabel ini (uji A1-A3 lurus,
    lateral 0 cm), jadi hanya isi spinCW()/spinCCW() yang ditukar.
2026-10-05 kompensasi inersia putar: motor mati 15° sebelum target
    Setelah arah putar diperbaiki, B1 (CW:45) dengan motor dimatikan di 42°
    masih berakhir di 54,7° dan 58,6° menurut MPU: robot terus berputar
    ± 15° setelah motor mati. TURN_TOLERANCE (3°) diganti TURN_COAST_DEG
    (15°), dengan batas bawah 30% sudut perintah agar putaran kecil tetap
    berjalan.
2026-10-05 hasil uji gerak A-B-C1 + dokumen disesuaikan pelaksanaan
    - Lembar_Data_Pengujian.xlsx: data A1-A3, B1-B4 (mozaik + yaw dari log), C1 3x
    - ukur_foto_c1.py + foto_c1/: hitung galat posisi & arah C1 dari foto awal-akhir
    - buat_hasil.py -> Hasil_Pengujian_Gerak.docx/pdf (menggantikan laporan progres)
    - Rancangan: C2 dihapus, metode B (mozaik pelampung) & C1 (foto), hasil
    tahap pendahuluan, bagian 11 perubahan terhadap rancangan awal
    - buat_lembar_data.py: buang fungsi migrasi format lama, tidak menimpa file berisi data
    [Lembar_Data_Pengujian.xlsx, Lembar_Data_Pengujian_Sebelum Kalibrasi.xlsx]
2026-10-09 C1 diukur di tiap titik belok: lembar isian + grafik rute vs aktual
    Masukan dospem: C1 diukur pakai meteran dan busur di tiap titik belok,
    lalu dibuat grafik seperti Fig. 4 / Tabel I paper rujukan (Putra &
    Saputra, 2022). Data C1 yang ada hanya foto awal & akhir, jadi C1 perlu
    diambil ulang dengan cara ini.
    - buat_grafik_c1.py --lembar: Lembar_Data_C1_Titik_Belok.xlsx, isian X/Y
    titik tengah robot (meteran dari dinding kiri & belakang) dan simpangan
    arah (busur) di S, T1-T4, dan Akhir untuk 3 percobaan. Rute rencana,
    galat posisi, dan MAE per titik terhitung otomatis di Excel.
    - buat_grafik_c1.py: gambar/fig_c1_rute_aktual.png (rute rencana vs posisi
    aktual per percobaan, di dalam d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
    [Lembar_Data_C1_Titik_Belok.xlsx]
2026-10-09 C1 diukur dari titik belok ke titik belok sesuai arahan dospem
    Arahan dospem: robot dibiarkan menjalankan kotak tanpa diukur dari titik
    awal; tiap titik belok diberi penanda, penanda dihubungkan benang, lalu
    jarak antar titik belok diukur meteran di atas air dan sudut di tiap
    titik belok diukur busur memakai benang. Posisi menurut MPU disandingkan
    dengan aktual karena hanya hasil perhitungan.
    - Lembar isian diganti: per segmen jarak aktual (meteran), sudut dalam
    di ujung segmen (busur), dan yaw MPU dari log saat FIN FW. Galat jarak,
    sudut belok aktual & MPU, dan MAE per segmen terhitung di Excel.
    - Lintasan aktual direkonstruksi dari jarak + sudut (poligon), lintasan
    menurut robot dar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
    [Lembar_Data_C1_Titik_Belok.xlsx]
2026-10-09 C1: gambar cara pasang penanda, tiang, benang, dan busur
    Pertanyaan praktis setelah arahan dospem: bagaimana menandai titik belok
    dan menarik benang di atas air.
    - --cara kini juga membuat fig_c1_pasang_benang.png: (1) pemberat ditaruh
    di dasar kolam di bawah titik acuan robot saat FIN FW, (2) setelah robot
    selesai, tiang didirikan di atas tiap pemberat dan benang diikat di
    ketinggian yang sama, (3) busur datar di atas benang dengan 0° sejajar
    benang ke titik sebelumnya.
    - "Titik tengah" diganti "titik acuan robot": bagian tengah robot tertutup
    kotak elektronik, jadi dipakai satu titik di badan robot yang sedekat
    mungkin ke tengah dan selalu sama.
    [Lembar_Data_C1_Titik_Belok.xlsx]
2026-10-09 Panduan pengujian C1: dudukan botol + sok, benang, busur, dan log MPU
    Dokumentasi lengkap uji C1 yang diukur dari titik belok ke titik belok,
    memakai dudukan penanda yang disepakati: botol isi pasir dengan pipa
    pendek PVC diikat di sampingnya dan sok di ujung atas, lalu pipa panjang
    dicolok ke sok setelah robot selesai.
    - buat_panduan_c1.py -> Panduan_Pengujian_C1.docx/.pdf (8 halaman):
    alat & bahan, cara membuat dudukan, titik acuan robot, pembagian tugas,
    prosedur saat robot berjalan, pemasangan benang, pembacaan busur, cek
    siku 60-80-100, pengambilan yaw MPU dari log, pengolahan data,
    keselamatan, dan daftar periksa.
    - Gambar baru: rakitan dudukan, sketsa titik acuan & zona balin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
2026-10-14 Samakan flowchart FW/belok dan screenshot GUI dengan kode terbaru
    - flowchart.md bagian 5: durasi FW = FW_START_MS + jarak/kecepatan
    (2100 ms + jarak ÷ 0,28 m/s), koreksi heading hanya saat MPU sehat
    - flowchart.md bagian 6: stopDeg = max(deg − 15°, 0,3 × deg) sebagai
    kompensasi inersia, cabang open-loop saat MPU mati, catatan kabel ESC
    tersilang
    - render ulang PNG diagram 06-5 dan 07-6
    - ambil ulang 7 screenshot GUI (5 jalur / 37 perintah untuk 10×4 m,
    kecepatan 0,28 m/s) agar sama dengan isi skripsi
2026-10-14 C1 cara koordinat: lembar X/Y dari dinding + grafik membacanya
    Pipa panjang tidak bisa berdiri di kolam dan tim hanya 3 orang, jadi
    botol dipakai sebagai penanda lantai saja. Setelah robot diangkat, tiap
    titik (S = koin, T1..T4 = botol) diukur X dari dinding kiri dan Y dari
    dinding belakang. Lembar_Data_C1_Koordinat.xlsx menghitung jarak antar
    titik, sudut belok, galat posisi, dan selisih yaw MPU; buat_grafik_c1.py
    membaca lembar ini bila ada, selain itu tetap lembar cara benang.
    [Lembar_Data_C1_Koordinat.xlsx]
2026-10-14 C1: yaw segmen = rata-rata yaw selama FW, bukan cuplikan saat FIN
    Cuplikan tunggal saat FIN sering kena ayunan sesaat di ujung gerak
    (mis. 168° → −179° di detik terakhir FW:200), sehingga sudut belok
    menurut MPU melenceng hingga 20°. --log kini mencetak rata-rata yaw
    (sirkular) dari ON sampai FIN tiap FW; nilai itu yang disalin ke kolom
    Yaw lembar koordinat.
    [Lembar_Data_C1_Koordinat.xlsx]
2026-10-14 Lembar C1 cara benang: kolom yaw juga rata-rata selama FW
    Samakan dengan lembar koordinat: kolom F diisi rata-rata yaw selama
    tiap FW dari --log, bukan cuplikan saat FIN.
    [Lembar_Data_C1_Titik_Belok.xlsx]
2026-10-14 Hasil uji ulang C1 per titik belok + grafik rute dan galat
    Data tiga percobaan (meteran + busur di tiap titik belok, yaw rata-rata
    selama FW dari log GUI) dimasukkan ke Lembar_Data_C1_Titik_Belok.xlsx.
    Galat posisi aktual MAE 0,7 cm; sudut belok IMU vs aktual MAE 3,4° pada
    percobaan 2–3 (jeda 6–12 s) dan 31,2° pada percobaan 1 (jeda hingga 23 s).
    Grafik: batas peta menyesuaikan semua titik (lintasan menurut robot
    percobaan 1 keluar dari bingkai lama), huruf diperbesar agar terbaca
    saat dimuat di dokumen, label nilai biru dipindah ke kanan titik supaya
    tidak menutupi label sumbu. Tanpa --xlsx, lembar yang dibaca adalah
    lembar pertama yang sudah berisi data.
    [Lembar_Data_C1_Titik_Belok.xlsx]
