Xhorn7/Skripsi-PENGEMBANGAN-ROBOT-AKUATIK-UNTUK-FEEDER-OTOMATIS-DI-TAMBAK/(notices)

Notices in the files:
Test Part/MPU Test/ArduinoCode.ino:
The text and figures in this code and instructions are licensed under a Creative Commons Attribution - Noncommercial - ShareAlike 4.0 International Public Licence.
